maxnil/ESP_WeatherSensor_PCB/ESP_WeatherStation.png

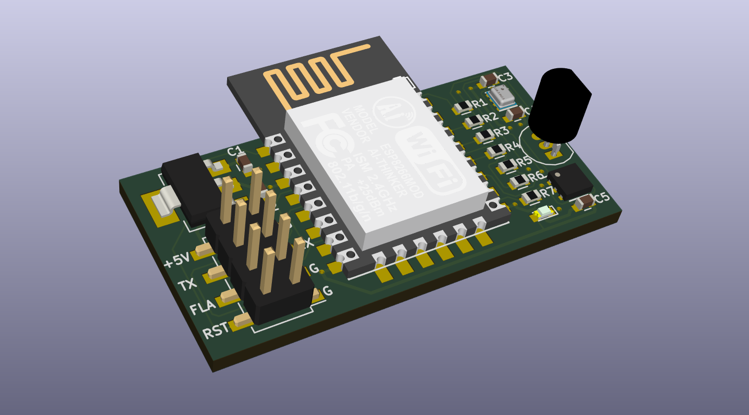
ESP_WeatherStation.png
