maxnil/ESP_WeatherSensor_PCB/README.md

# ESP_WeatherStation_PCB
Simple weather station (temperature, humidity and air pressure) based around a ESP8266 module
