maxnil/ESP_WeatherSensor_PCB/test.kicad_pcb

## KiCad design test.kicad_pcb (2018-03-13)

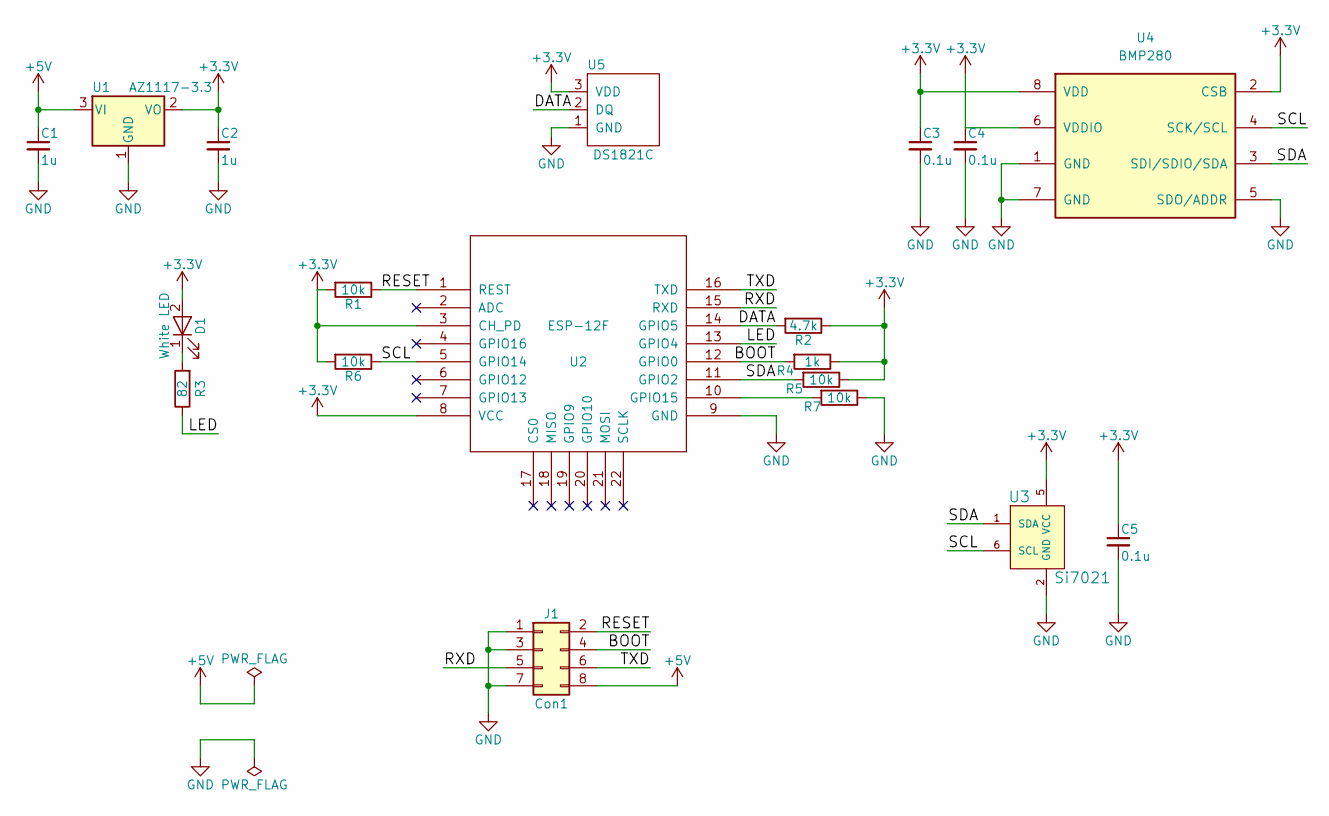
[picture p2: schematic ESP_WeatherStation.sch]

Parts:
C1, C2: 1u; C_0603
C3, C4, C5: 0.1u; C_0603
D1: White LED; LED_0603
J1: Con1; Pin_Header_Straight_2x04_Pitch2.54mm_SMD
R1, R5, R6, R7: 10k; R_0603
R2: 4.7k; R_0603
R3: 82; R_0603
R4: 1k; R_0603
U1: AZ1117-3.3; SOT-223
U2: ESP-12F; ESP-12E_SMD
U3: Si7021; DFN-6-1EP_3x3mm_Pitch0.95mm
U4: BMP280; BOSCH_BMP280; MPN BMP280
U5: DS1821C; TO-92_Inline_Narrow_Oval

Connections:
+3V3: C2.1, C3.1, C4.1, C5.1, D1.2 (A), R1.2, R2.1, R4.1, R5.1, R6.2, U1.2 (VO), U2.3 (CH_PD), U2.8 (VCC), U3.5 (VCC), U4.2 (CSB), U4.6 (VDDIO), U4.8 (VDD), U5.3 (VDD)
+5V: C1.1, J1.8, U1.3 (VI)
/BOOT: J1.4, R4.2, U2.12 (GPIO0)
/DATA: R2.2, U2.14 (GPIO5), U5.2 (DQ)
/LED: R3.1, U2.13 (GPIO4)
/RESET: J1.2, R1.1, U2.1 (REST)
/RXD: J1.5, U2.15 (RXD)
/SCL: R6.1, U2.5 (GPIO14), U3.6 (SCL), U4.4 (SCK/SCL)
/SDA: R5.2, U2.11 (GPIO2), U3.1 (SDA), U4.3 (SDI/SDIO/SDA)
/TXD: J1.6, U2.16 (TXD)
GND: C1.2, C2.2, C3.2, C4.2, C5.2, J1.1, J1.3, J1.7, R7.1, U1.1 (GND), U2.9 (GND), U3.2 (GND), U4.1 (GND), U4.5 (SDO/ADDR), U4.7 (GND), U5.1 (GND)
unnamed: D1.1 (K), R3.2
unnamed: R7.2, U2.10 (GPIO15)

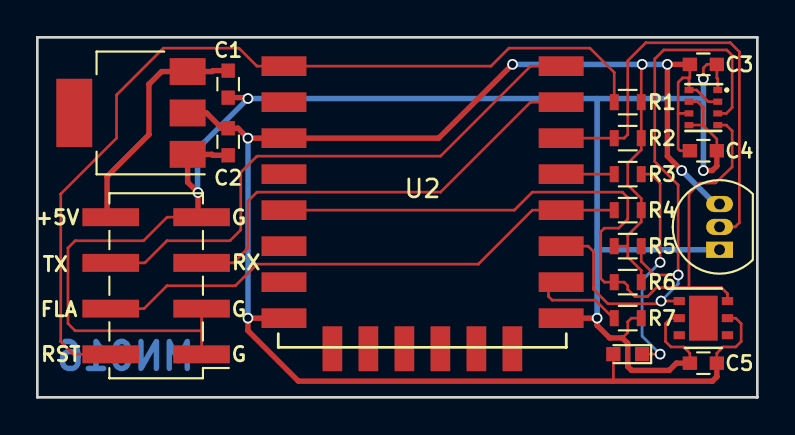
[picture p3: board test.kicad_pcb from above]

Board: 2 copper layers, 40.0 x 20.0 mm, 19 parts (0 on the bottom side), 13 nets.
