maxnil/ESP_WeatherSensor_PCB/(threads)

Thread 1 (2019-05-17):

Temperature sensors too close to ESP8266 module

maxnil, 2019-05-17:
The ESP8266 heats up the temperature sensors on the board, so the humidity readout and DS18B20 temperature is too high.

maxnil, 2019-05-17:
This has been fixed in the updated project: ESP_WratherSensor_v2.0_PCB

Closed 2019-05-17.
