maxnil/ESP_WeatherSensor_PCB/(commit log)

2018-03-07 First version
    [ESP_WeatherStation.kicad_pcb, ESP_WeatherStation.sch]
2018-03-13 Final version
    [ESP_WeatherStation.kicad_pcb, ESP_WeatherStation.sch]
2018-04-22 Full BOM
    [ESP_WeatherStation_BOM.xlsx]
2018-04-22 BOM .csv file
    [ESP_WeatherStation_BOM.csv]
