maxnil/ESP_WeatherSensor_PCB/(notices)

Notices in the files:
test.kicad_pcb:
(c)2018 MaxNil
